shuvabratadey/ESP32_OBD_Scanner/Photos/OBD-II.jpg

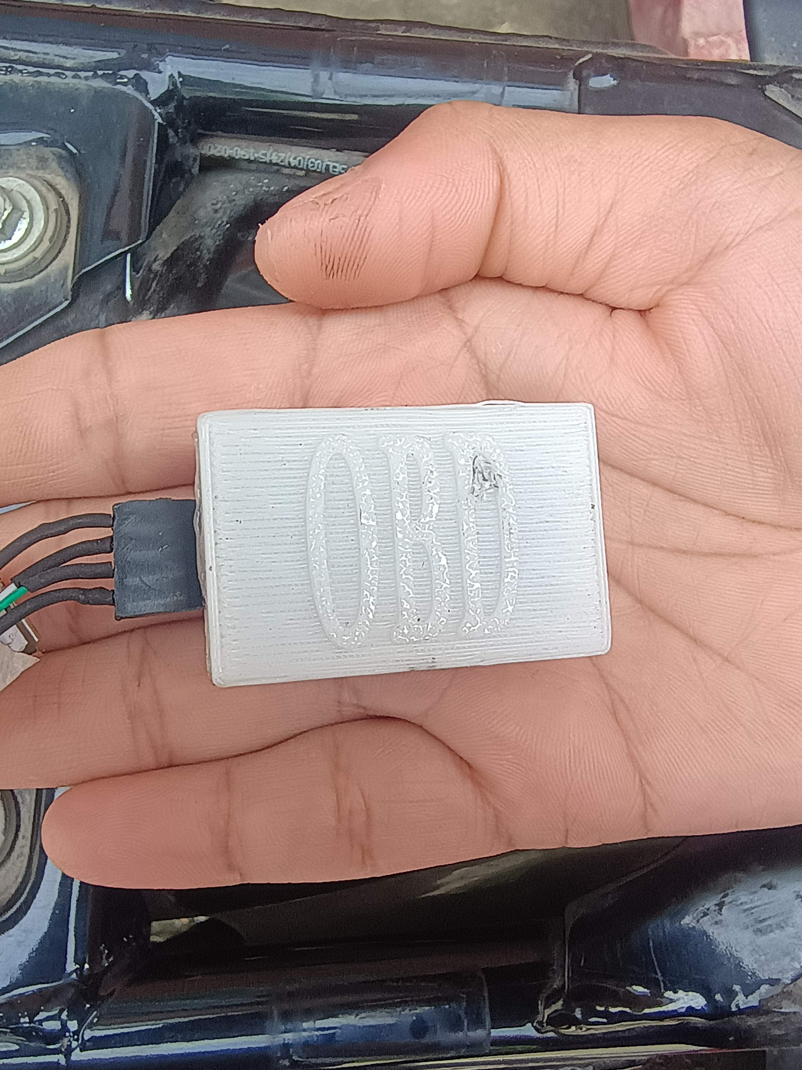
Photos/OBD-II.jpg
