shuvabratadey/ESP32_OBD_Scanner/Photos/OBD-II_Connection_Details.png

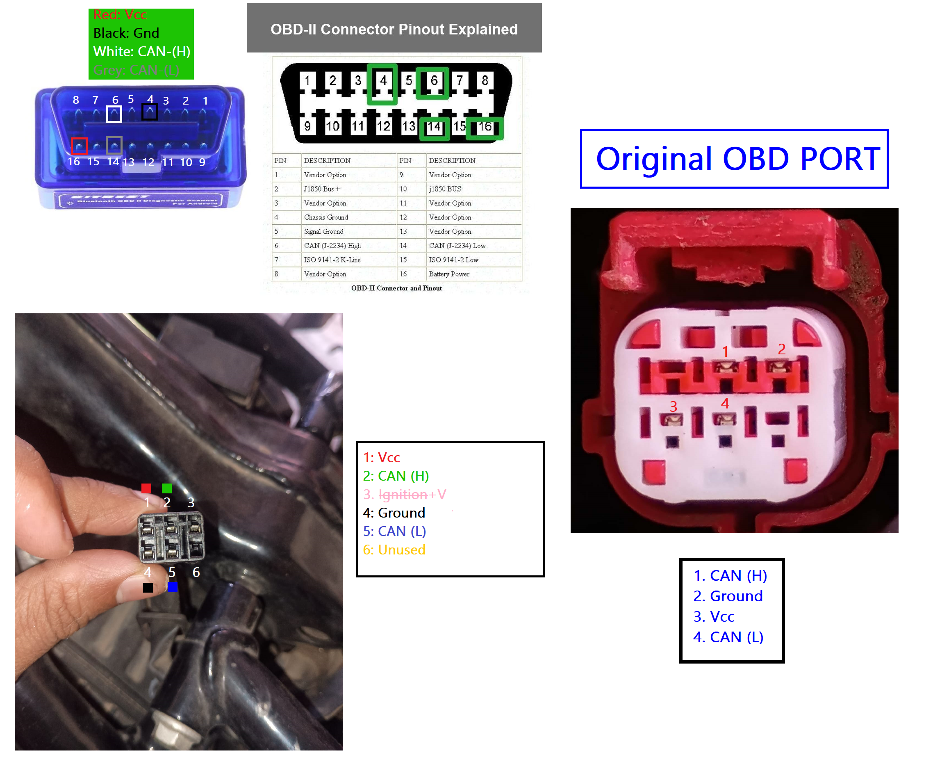
Photos/OBD-II_Connection_Details.png
