shuvabratadey/ESP32_OBD_Scanner/Photos/Others/IMG_20260502_121229039.jpg

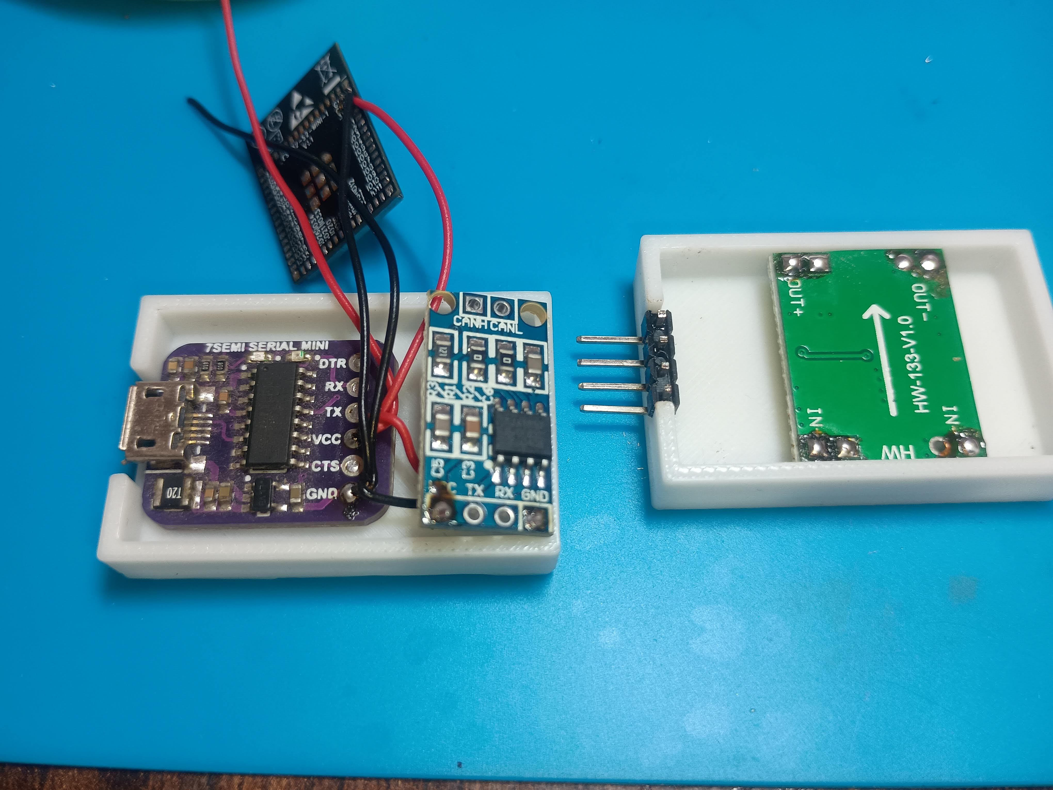
Photos/Others/IMG_20260502_121229039.jpg
