shuvabratadey/ESP32_OBD_Scanner/Photos/Others/IMG_20260502_132306277.jpg

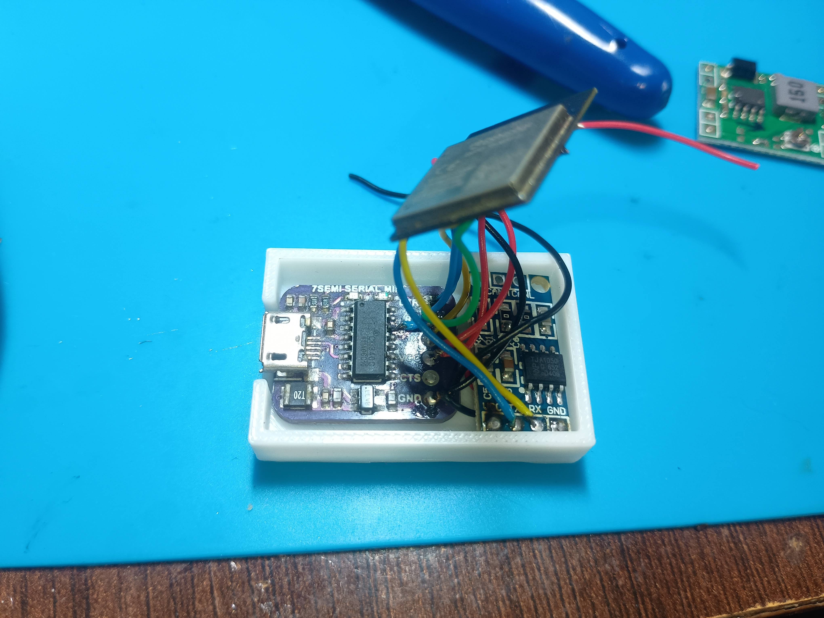
Photos/Others/IMG_20260502_132306277.jpg
