shuvabratadey/ESP32_OBD_Scanner/Photos/Others/IMG_20260502_181334109.jpg

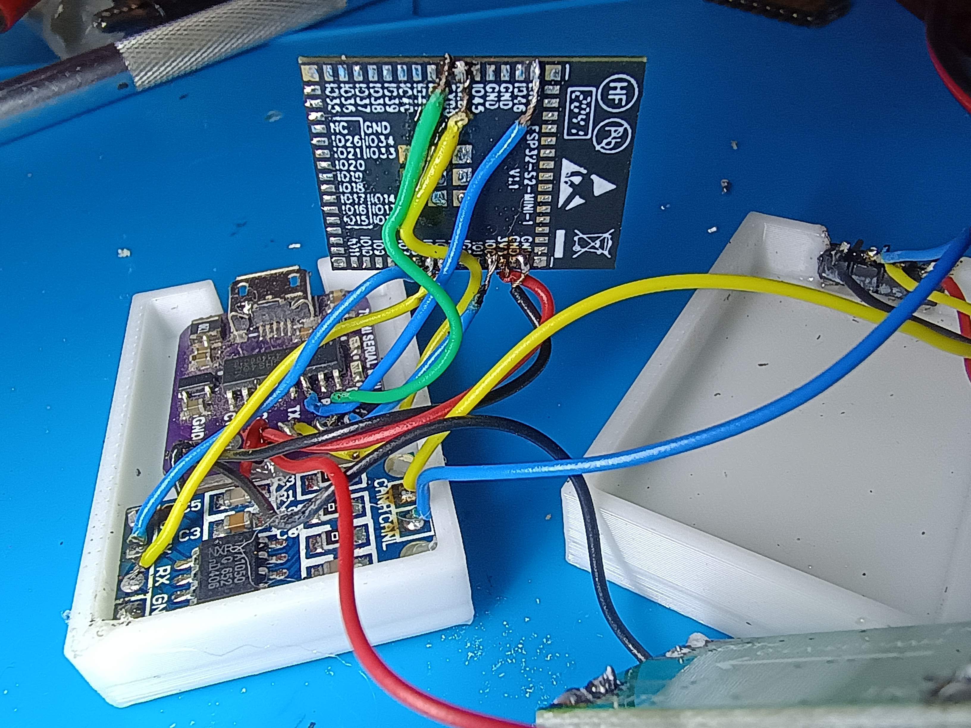
Photos/Others/IMG_20260502_181334109.jpg
