shuvabratadey/ESP32_OBD_Scanner/Photos/video_thumbnail.png

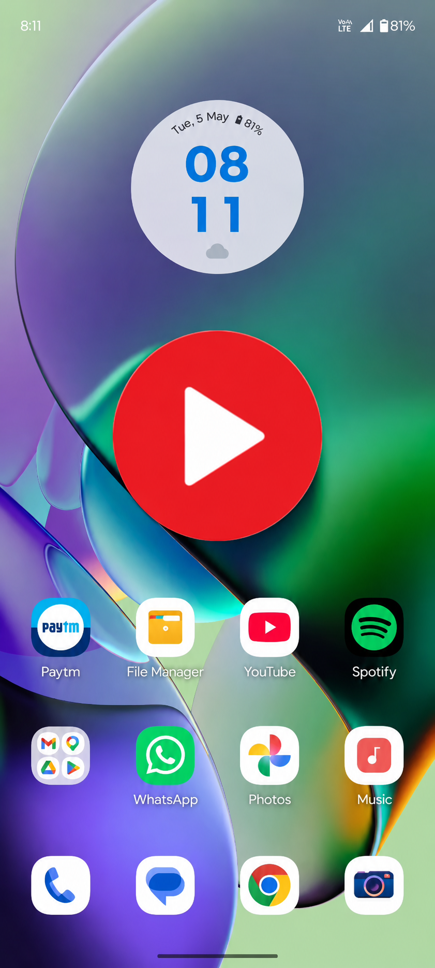
Photos/video_thumbnail.png
