shuvabratadey/ESP32_OBD_Scanner/obd2_guide.html

OBD2 Serial Debug Reference

# ELM327 AT Command Complete Guide

Device: ELM327 Mini Bluetooth Interface: Windows Serial Debug Assistant Standard: SAE J1979 / ISO 15765

// Table of Contents

1. What is OBD2?
2. ELM327 Mini — Hardware Overview
3. CAN Bus Protocol Explained
4. All AT Commands Reference
5. Setting Up Serial Debug Assistant
6. Step-by-Step Debugging Guide
7. OBD2 PID Commands
8. Decoding Responses
9. Master Debug Sequence
10. Troubleshooting

## 01 What is OBD2?

OBD2 (On-Board Diagnostics, Version 2) is a standardized system built into all cars (1996+) and most motorcycles (2003+) that exposes the vehicle's internal sensors, ECU data, and diagnostic trouble codes (DTCs) through a standard 16-pin connector.

The ELM327 chip acts as a translator between the vehicle's proprietary protocol (CAN, ISO, VPW, PWM) and a simple human-readable AT command interface over Bluetooth serial.

[Your Laptop] ←─ Bluetooth Serial ─→ [ELM327 Mini] ←─ OBD2 Wire ─→ [Vehicle ECU]

⚠ Clone Warning: Most "Mini" ELM327 adapters sold cheaply are clones of the original chip. They work for basic OBD2 reading but may report firmware version incorrectly, have limited AT command support, fail on some advanced CAN protocols, or drop connections intermittently.

## 02 ELM327 Mini — Hardware Overview

┌──────────────────────────────────────────────┐
│          ELM327 Mini Bluetooth OBD2          │
│                                              │
│  ┌──────────┐   ┌──────────┐                 │
│  │ ELM327   │   │Bluetooth │                 │
│  │  Chip    │───│  Module  │    LED Indicators
│  │ (Parser) │   │ HC-05/06 │    🔴 Power
│  └──────────┘   └──────────┘    🟢 Connected
│       │                         🔵 Activity
│  ┌────┴──────────────────────────────────┐   │
│  │  OBD2 16-Pin Connector                │   │
│  │  Pin 4:  Chassis Ground               │   │
│  │  Pin 5:  Signal Ground                │   │
│  │  Pin 6:  CAN High (ISO 15765-4)       │   │
│  │  Pin 7:  K-Line (ISO 9141-2)          │   │
│  │  Pin 14: CAN Low (ISO 15765-4)        │   │
│  │  Pin 16: Battery (+12V)               │   │
│  └───────────────────────────────────────┘   │
└──────────────────────────────────────────────┘

Property | Value
Chip | ELM327 v1.5 / v2.1 (clone)
Bluetooth | SPP (Serial Port Profile)
Default Baud Rate | 38400 bps
Voltage Input | 12V from OBD2 Pin 16
Protocols Supported | All 5 OBD2 protocols
Pairing PIN | 1234 or 0000

## 03 CAN Bus Protocol Explained

CAN (Controller Area Network) is the most common modern vehicle protocol. Understanding it helps decode raw OBD2 responses.

### CAN Frame Structure

┌────────┬──────────┬──────┬───────────────────────┬─────┐
│  SOF   │  CAN ID  │  DLC │        Data           │ CRC │
│ 1 bit  │ 11 bits  │ 4bit │   Up to 8 bytes       │     │
└────────┴──────────┴──────┴───────────────────────┴─────┘

### OBD2 CAN IDs (Standard 11-bit)

CAN ID | Direction | Description
0x7DF | Tester → ECU | Functional broadcast (all ECUs listen)
0x7E0 | Tester → ECU 1 | Physical address to Engine ECU
0x7E8 | ECU 1 → Tester | Response from Engine ECU
0x7E1 | Tester → ECU 2 | Transmission ECU
0x7E9 | ECU 2 → Tester | Response from Transmission ECU

### OBD2 CAN Message Example — Send 010D (Vehicle Speed)

// REQUEST  (Tester → ECU via 0x7DF)
Byte 0: 02           = 2 data bytes follow
Byte 1: 01           = Mode 01 (current data)
Byte 2: 0D           = PID 0x0D (vehicle speed)
Bytes 3-7: 00 00 00 00 00  (padding)

// RESPONSE (ECU → Tester via 0x7E8)
Byte 0: 03           = 3 data bytes follow
Byte 1: 41           = 0x40 + Mode (0x01) = positive response
Byte 2: 0D           = PID echoed back
Byte 3: XX           = Actual speed value in km/h

## 04 All AT Commands Reference

AT Commands are sent directly to the ELM327 chip — not to the vehicle. They configure the adapter's behavior.

### General / Reset Commands

Command | Description | Example Response
ATZ | Reset all settings to default | ELM327 v1.5
ATD | Set all to defaults (keeps baud rate) | OK
ATWS | Warm start (like ATZ but faster) | ELM327 v1.5
ATI | Print version ID | ELM327 v1.5
AT@1 | Display device description | OBDII to RS232 Interpreter

### Echo and Output Formatting

Command | Description | Default
ATE0 | Echo OFF — recommended for clean output | Echo ON
ATE1 | Echo ON | —
ATL0 | Linefeeds OFF | —
ATH0 | Headers OFF — hide CAN IDs | Headers OFF
ATH1 | Headers ON — show CAN IDs | —
ATS0 | Spaces OFF in response bytes | Spaces ON
ATS1 | Spaces ON between response bytes | —

### Timing Commands

Command | Description
ATAT0 | Adaptive timing OFF
ATAT1 | Adaptive timing ON — recommended
ATAT2 | Aggressive adaptive timing
ATST FF | Set timeout to 1020ms (FF × 4ms)

### Protocol Commands

Command | Description
ATSP0 | Auto-detect protocol — always try this first
ATSP1 | SAE J1850 PWM — Ford (1996–2007)
ATSP2 | SAE J1850 VPW — GM / Chrysler
ATSP3 | ISO 9141-2 — European / Asian older vehicles
ATSP4 | ISO 14230-4 KWP (5-baud init)
ATSP5 | ISO 14230-4 KWP (fast init)
ATSP6 | ISO 15765-4 CAN 11-bit 500K — most modern cars
ATSP7 | ISO 15765-4 CAN 29-bit 500K
ATSP8 | ISO 15765-4 CAN 11-bit 250K
ATSP9 | ISO 15765-4 CAN 29-bit 250K
ATDP | Describe current protocol (text)
ATDPN | Describe protocol by number
ATPC | Protocol close

### Advanced / Monitoring Commands

Command | Description
ATMA | Monitor all messages on bus
ATRV | Read battery voltage
ATIGN | Read ignition voltage
ATCSM1 | CAN silent monitoring ON
ATPPS | Print all programmable parameters

## 05 Setting Up Serial Debug Assistant

### Step 1 — Pair the ELM327 via Bluetooth

1. Plug the ELM327 Mini into the vehicle OBD2 port (ignition ON)
2. Red LED on adapter should illuminate
3. Windows: Settings → Bluetooth & devices → Add device
4. Look for OBDII, ELM327, or V-LINK
5. Enter pairing PIN: 1234 (or try 0000)
6. A virtual COM port is created — note it (e.g., COM4, COM5)

### Step 2 — Find the COM Port

Right-click Start → Device Manager → Ports (COM & LPT)

  Standard Serial over Bluetooth link (COM4)   ← Use this (outgoing)
  Standard Serial over Bluetooth link (COM5)   ← Incoming (ignore)

### Step 3 — Serial Debug Assistant Settings

Setting | Value
COM Port | Your COM port (e.g., COM4)
Baud Rate | 38400
Data Bits | 8
Parity | None
Stop Bits | 1
Flow Control | None
Send Format | ASCII Text
Line Ending | \r (Carriage Return only)

Critical: ELM327 uses Carriage Return \r as command terminator — NOT newline \n. Ensure your Serial Debug Assistant appends only \r to each sent command.

## 06 Step-by-Step Debugging Guide

1

Connection & Reset

Command 1 — Reset ELM327

Send:    ATZ
Receive: ELM327 v1.5
         >

The > prompt means ELM327 is ready.

Command 2 — Echo OFF

Send:    ATE0
Receive: OK

Command 3 — Headers ON

Send:    ATH1
Receive: OK

Command 4 — Adaptive Timing ON

Send:    ATAT1
Receive: OK

2

Protocol Detection

Command 5 — Auto-detect Protocol

Send:    ATSP0
Receive: OK

Command 6 — Verify Detected Protocol

Send:    ATDP
Receive: AUTO, ISO 15765-4 (CAN 11/500)

Command 7 — Read Battery Voltage

Send:    ATRV
Receive: 12.4V

Tip: If you see 0.0V or NO DATA, the adapter is not connected properly to the vehicle.

3

Vehicle Communication Test

Command 8 — Request Supported PIDs

Send:    0100
Receive: 7E8 06 41 00 BE 3F A8 13

This is the most important test. A response here means your vehicle ECU is communicating. NO DATA or UNABLE TO CONNECT → see Troubleshooting.

4

Read Live Data

// Engine RPM
Send:    010C     Receive: 7E8 04 41 0C 1A F8

// Vehicle Speed
Send:    010D     Receive: 7E8 03 41 0D 3C

// Coolant Temperature
Send:    0105     Receive: 7E8 03 41 05 7B

// Throttle Position
Send:    0111     Receive: 7E8 03 41 11 64

5

Read Diagnostic Trouble Codes

// Read stored DTCs
Send:    03
Receive: 7E8 06 43 01 P0300 00 00   (fault detected)

// Or if no faults:
Receive: 7E8 02 43 00

// Clear DTCs — USE WITH CAUTION
Send:    04
Receive: 7E8 01 44

⚠️ Clearing DTCs also resets all readiness monitors. The vehicle may fail an emissions test until all monitors complete their drive cycles.

🔍 Search Engine Fault Codes (https://b0200.enginefaultcode.com/) 📄 ELM327 Full Datasheet (https://www.scantool.net/scantool/downloads/103/elm327dsh.pdf)

## 07 OBD2 PID Commands

A command like 010C breaks down as: Mode 01 + PID 0C. The ECU replies with mode + 0x40:

Request:   01 0C      → Mode 01, PID 0C (Engine RPM)
Response:  41 0C 1A F8  → Positive response, data bytes follow
           ── ── ───────
           41 = 0x40 + mode 0x01 (positive response)
           0C = PID echoed
           1A F8 = actual data bytes A, B

### Service Modes Overview

Mode | Meaning | Example | Returns
01 | Live / current data | 010C | Real-time ECU values (RPM, speed, temp…)
02 | Freeze frame data | 020C | Snapshot captured when fault occurred
03 | Read stored DTCs | 03 | Trouble codes in ECU memory
04 | Clear DTCs + reset monitors | 04 | Clears codes and readiness data
07 | Read pending DTCs | 07 | Faults not yet matured into stored codes
09 | Vehicle information | 0902 | VIN, ECU name, calibration IDs

### Mode 01 — Live Data PIDs

Command | PID | Description | Formula | Unit
0100 | 00 | Supported PIDs 01–20 | Bitmask | —
0104 | 04 | Calculated engine load | A × 100/255 | %
0105 | 05 | Engine coolant temperature | A − 40 | °C
010A | 0A | Fuel pressure | A × 3 | kPa
010B | 0B | Intake manifold pressure | A | kPa
010C | 0C | Engine RPM | (256A + B) / 4 | RPM
010D | 0D | Vehicle speed | A | km/h
010E | 0E | Timing advance | A/2 − 64 | °
010F | 0F | Intake air temperature | A − 40 | °C
0110 | 10 | MAF air flow rate | (256A + B) / 100 | g/s
0111 | 11 | Throttle position | A × 100/255 | %
011F | 1F | Run time since engine start | 256A + B | s
012F | 2F | Fuel tank level | A × 100/255 | %
0133 | 33 | Barometric pressure | A | kPa
015C | 5C | Engine oil temperature | A − 40 | °C

### Mode 09 — Vehicle Information

Command | Description
0902 | VIN (Vehicle Identification Number) — ASCII decode
090A | ECU name string

## 08 Decoding Responses

### Response Anatomy (Headers ON — ATH1)

7E8  03  41  0D  3C
 │    │   │   │   └── Data byte A = 0x3C = 60 decimal
 │    │   │   └─────── PID echoed (0x0D = Vehicle Speed)
 │    │   └─────────── Response mode (0x41 = 0x40 + Mode 01)
 │    └─────────────── Number of following data bytes (3)
 └──────────────────── CAN ID of responding ECU (0x7E8 = Engine ECU)

### Example 1 — Engine RPM 010C

7E8→Engine ECU responding

04→4 data bytes follow

41→Mode 01 positive response

0C→PID = RPM confirmed

1A F8→A = 0x1A = 26, B = 0xF8 = 248

Formula: RPM = (256 × A + B) / 4
       = (256 × 26 + 248) / 4
       = 6904 / 4
       = 1726 RPM

### Example 2 — Vehicle Speed 010D

Response: 7E8 03 41 0D 3C
Formula:  Speed = A = 0x3C = 60 decimal = 60 km/h

### Example 3 — Coolant Temperature 0105

Response: 7E8 03 41 05 7B
Formula:  Temp = A − 40 = 123 − 40 = 83°C

### Example 4 — Throttle Position 0111

Response: 7E8 03 41 11 64
Formula:  Throttle = A × 100 / 255 = 100 × 100 / 255 = 39.2%

### DTC Decoding (Mode 03)

Response: 43 02 03 00 01 30
          ── ──
          43 = Mode 03 response
          02 = 2 DTCs stored

DTC byte pair: Hi=0x03, Lo=0x00
  Top 2 bits of Hi (00) → P (Powertrain)
  → P0300 — Random/Multiple Cylinder Misfire

Prefix table:
  0x0X = P0  (Powertrain, generic)
  0x4X = C0  (Chassis)
  0x8X = B0  (Body)
  0xCX = U0  (Network)

## 09 Master Debug Sequence

Paste these commands in order into Serial Debug Assistant for a complete vehicle health check:

ATZ      → Reset ELM327
ATE0     → Echo off
ATH1     → Show CAN IDs
ATAT1    → Adaptive timing
ATSP0    → Auto-detect protocol
ATRV     → Battery voltage check
0100     → ECU communication test
010C     → Engine RPM
010D     → Vehicle speed
0105     → Coolant temperature
0111     → Throttle position
012F     → Fuel level
03       → Read all DTCs

### Expected Output

ELM327 v1.5
OK
OK
OK
OK
12.4V
7E8 06 41 00 BE 3F A8 13
7E8 04 41 0C 1A F8        → 1726 RPM
7E8 03 41 0D 00           → 0 km/h (stationary)
7E8 03 41 05 7B           → 83°C
7E8 03 41 11 19           → 9.8% throttle
7E8 03 41 2F A0           → 62.7% fuel
7E8 02 43 00              → No DTCs

## 10 Troubleshooting

Problem | Cause | Fix
NO DATA | Wrong protocol / ECU not responding | Try ATSP0 to auto-detect; ensure ignition is ON
UNABLE TO CONNECT | Protocol mismatch | Try ATZ, then manually set ATSP1–ATSP9
BUS INIT: ERROR | K-Line init failed | Vehicle may use CAN; try ATSP6
? response | Unknown AT command | Check command spelling — no spaces within command
No response at all | Wrong COM port or baud mismatch | Check Device Manager; try baud 9600 or 115200
ELM327 not in Bluetooth scan | Adapter not powered | Ignition must be ON when pairing
Voltage shows 0.0V | Bad OBD port connection | Re-seat adapter; check OBD port fuse
DTC clear doesn't work | ECU requires physical address | Try ATSH 7E0 then send 04

## REF Quick Reference Card

// AT Commands

ATZReset adapter

ATE0Echo off

ATH1Show headers

ATAT1Adaptive timing

ATSP0Auto protocol

ATRVBattery voltage

ATDPCurrent protocol

// OBD PIDs

0100Supported PIDs + ECU test

010CRPM → (256A+B)/4

010DSpeed → A km/h

0105Coolant → A−40°C

0111Throttle → A×100/255%

03Read DTCs

04Clear DTCs

0902Read VIN

COM Settings: 38400 baud · 8N1 · No flow control · CR \r terminator

ELM327 Mini Bluetooth OBD2 — Windows Serial Debug Assistant Reference

Protocol Standards: SAE J1979 · ISO 15765-4 · ISO 9141-2 · ISO 14230-4 · SAE J1850
